pmixay/3d-project/submission/Hercules_opisanie_proekta.docx

Отраслевой молодёжный чемпионат по аддитивным технологиям «3D Профи»

IMPRINTA HERCULES: НОВЫЙ ПРИНТЕР НА СТАРОЙ РАМЕ

пересборка серийного 3D-принтера 2016 года: от оригинала остались только рама и механика осей

Направление: оборудование для 3D-печати. Команда: [Название команды]. Капитан: [Фамилия Имя], [учебное заведение], [e-mail / телефон].

1. Аннотация

Команда пересобрала серийный 3D-принтер Imprinta Hercules 2016 года. От оригинала осталась только механика: стальная рама 2 мм, линейные рельсы X и Y, ось Z, стол со стеклом, моторы осей NEMA17, ремни и дисплей. Всё остальное — электроника, печатная голова, хотенд, экструдер, драйверы, блок питания, проводка, обдув, калибровка, прошивка и программное обеспечение — новое. Принтер переведён на Klipper с 32-битной платой BigTreeTech SKR 3 EZ и платой EBB42 GEN2 на печатной голове, соединённых одним 4-жильным кабелем CAN. Печатная голова Hefest разработана командой с нуля. Автокалибровка стола контактным датчиком, компенсация резонансов, автоматическая чистка сопла и ИИ-контроль печати дают функции современных принтеров уровня Bambu Lab. Результат оценивается относительно исходного серийного Hercules (раздел 3).

2. Актуальность и необходимость

Устаревший парк оборудования. В 2015–2020 годах школы, детские технопарки «Кванториум», центры «Точка роста» и «IT-куб», ЦМИТ и вузы массово получили 3D-принтеры. Сегодня это первое поколение: 8-битная электроника, ручная калибровка, низкая скорость, отсутствие защиты и контроля печати. Такие принтеры простаивают или используются как демонстрационные, хотя их рама и механика исправны.

Высокая стоимость замены. Новый быстрый закрытый принтер класса Bambu Lab P1S стоит от 70 000 ₽ в российской рознице — для школы или кружка это бюджет на оснащение целого кабинета. При замене исправная механика старого принтера уходит в утиль.

Зависимость от закрытых экосистем. Современные быстрые принтеры опираются на фирменные запчасти, проприетарную прошивку и облачные сервисы производителя. Открытая прошивка Klipper, серийные компоненты и открытая документация дают ремонтопригодность на месте и независимость от одного поставщика.

Подготовка кадров для аддитивной отрасли. Пересборка принтера — готовый междисциплинарный учебный проект: электроника, САПР, прошивка, калибровка, метрология. Участники разбираются в устройстве оборудования, а не только пользуются им, — именно такие специалисты нужны отрасли.

Ресурсосбережение. Повторное использование рамы и механики продлевает срок службы оборудования и сокращает электронные и металлические отходы.

3. Исходный принтер и сравнение

Imprinta Hercules — принтер красноярской компании Imprinta, выпущенный в июне 2016 года: стальной каркас 2 мм, габариты 365×355×430 мм, масса около 15 кг, прямой экструдер с хотендом UniHOT, сопло 0,5 мм, ручная калибровка стола по трём точкам, заявленная скорость печати до 150 мм/с (по обзору 3Dtool на Хабре). Это типичный представитель первого поколения. Сравнение с исходным принтером:

Параметр | Серийный Hercules 2016 | Наш Hercules
Электроника | 8-битная плата, ~99 000 шагов/с | 32-битная SKR 3 EZ, более 1 800 000 шагов/с
Прошивка и управление | штатная прошивка, печать с SD-карты | Klipper, веб-интерфейс, хост на ноутбуке
Хотенд | UniHOT, до 260 °C | TriangleLab CHC Pro 115 Вт, до 300 °C
Сопло | латунное 0,5 мм | биметаллическое Volcano NCB, для композитов
Скорость печати | заявлено до 150 мм/с | цель — до 300 мм/с
Калибровка стола | ручная, по трём точкам | автоматическая, датчик 0,002 мм + адаптивная карта
Вибрации | не компенсируются | Input Shaper по встроенному акселерометру
Проводка к голове | многожильный жгут | один кабель CAN, 4 провода
Обслуживание | вручную | автоочистка сопла, ИИ-контроль печати

4. Цель и задачи

Цель — превратить устаревший серийный принтер в современный быстрый и автоматизированный принтер, сохранив только его прочную механику. Задачи:

- перевести принтер на Klipper с 32-битной платой и шиной CAN к печатной голове;
- спроектировать и напечатать собственную печатную голову Hefest под новую электронику;
- внедрить автокалибровку стола, автоматическую чистку сопла и компенсацию резонансов (Input Shaper);
- оформить решение как воспроизводимый комплект: список закупок, конфигурации, печатные детали, инструкции.

5. Техническое решение

5.1. Электроника. Плата BigTreeTech SKR 3 EZ (STM32H7, 480–550 МГц) обеспечивает более 1 800 000 шагов/с — в 18 раз больше, чем у 8-битной платы. Драйверы EZ2209 вставляются в закрытые слоты и управляются по UART, что позволяет применить klipper_tmc_autotune. Встроенный CAN-трансивер подключает плату печатной головы без отдельного адаптера. Питание — новый блок MeanWell LRS-350-24 (24 В, 350 Вт). Хостом Klipper служит ноутбук, подключённый по USB.

5.2. Плата на печатной голове. BIGTREETECH EBB42 GEN2 (40×45 мм) заменяет сразу шесть элементов: переходную плату с проводами на термоклее, внешний акселерометр с USB-кабелем, отдельный драйвер экструдера, 12-проводный жгут, длинные провода датчика и вентиляторов, генерацию шагов экструдера на основной плате. К голове идёт один кабель: 24 В, GND, CAN_H, CAN_L. Разъём XT30 рассчитан на 15 А при рабочем токе 2,94 А (пиковый при холодном старте керамического нагревателя — 5,44 А) — запас более чем в 5 раз. Выходы защищены от короткого замыкания и перегрузки, температура платы контролируется в Klipper.

5.3. Печатная голова Hefest (собственная разработка). Голова спроектирована командой в КОМПАС-3D под каретку MGN12H. Состав: силовая рама с вертикальной плитой экструдера и зажимом ремня, крышка ремня, треугольная ферма под рельсом X, две полуобоймы хотенда TriangleLab CHC Pro (передняя несёт вентилятор 3010), воздуховод обдува детали от вентилятора 5015 с выходами по обе стороны сопла. На голове размещаются экструдер K3D Minifeeder с мотором NEMA14 (редуктор 5:1), плата EBB42 GEN2 и датчик MicroProbe. Для проверки зазоров между деталями головы и ремнями написан собственный скрипт, проецирующий STL-модели вдоль рельса.

5.4. Автокалибровка стола. Стол накрыт стеклом 4 мм на зажимах: оно держит плоскость лучше тонкой алюминиевой плиты, которая коробится при нагреве до 80–110 °C. Индуктивные и вихретоковые датчики сквозь 4 мм стекла не работают, поэтому выбран контактный BIQU MicroProbe V2 (6 г, повторяемость 0,002 мм), который касается поверхности стекла металлическим штоком.

5.5. Программное обеспечение. Klipper + Klippain Shake&Tune (натяжение ремней по резонансным пикам, подбор фильтров Input Shaper по встроенному акселерометру), klipper_tmc_autotune, адаптивная карта стола KAMP, Adaptive Pressure Advance в OrcaSlicer, камера с ИИ-контролем Crowsnest + Obico (пауза при отрыве детали или «спагетти»). Макрос START_PRINT: нагрев сопла до 150 °C → чистка о силиконовую щётку → точное измерение Z-offset → карта высот только в области будущей детали → печать.

6. Бюджет

Позиция | Стоимость, ₽
Этап 1: хотенд CHC Pro, экструдер K3D Minifeeder + NEMA14, драйверы TMC, блок питания, вентиляторы | [сумма]
Плата BTT SKR 3 EZ с драйверами EZ2209 | 6 129
Плата печатной головы BTT EBB42 GEN2 V1.0 | 2 728
Датчик автокалибровки BIQU MicroProbe V2 | 1 669
Сопло TriangleLab Volcano NCB + щётки для чистки сопла | 959
Подающая шестерня RIDGA V2 для экструдера | 650
Вентилятор GDSTime 3010 + карбоновая балка X и PETG-CF | 3 180
Итого этап 2 (электроника и автоматизация) | 15 315
Полная стоимость пересборки | [итого]

Лимит этапа 2 — 20 000 ₽, запас — 4 685 ₽. Для сравнения: новый закрытый CoreXY-принтер класса Bambu Lab P1S Combo в российской рознице стоит около 70 000 ₽ и выше.

7. Техническая реализуемость

Все компоненты — серийные и доступные в России. Архитектура «плата на голове + один кабель» — отраслевой стандарт (Bambu Lab X1/P1/A1, Prusa XL, Creality K1/K2). Токи и нагрев рассчитаны заранее: рабочий ток головы 2,94 А, потери в кабеле менее 0,44 Вт, нагрев драйвера экструдера около 0,29 Вт; конструкция головы проверена на зазоры до ремней. Дальнейшая работа — доводка настроек: Input Shaper, Pressure Advance, токи драйверов и макросы.

8. Оригинальность и преимущества

- Собственная печатная голова Hefest, спроектированная под конкретную связку CHC Pro + K3D Minifeeder + EBB42 GEN2 + MicroProbe.
- Нестандартное решение для стекла: контактный датчик вместо популярных вихретоковых, которые через 4 мм стекла не работают.
- Инженерный подход: расчёт токов и тепла, собственный скрипт проверки зазоров головы — до изготовления.
- Глубокая пересборка: от серийного принтера осталась только механика; все остальные узлы подобраны и спроектированы командой как единая система.
- Функции флагманов: компенсация резонансов, автокалибровка, автоматическая чистка сопла, ИИ-контроль печати — на раме принтера 2016 года.

9. Потенциал коммерциализации

Продукт — пересборка устаревших принтеров на их собственной механике (Hercules и аналоги с прочным каркасом) вместо покупки нового принтера за 70 тыс. ₽ и выше. Целевые клиенты: школы, вузы, технопарки, ЦМИТ, кванториумы, небольшие мастерские и частные владельцы. Модели монетизации:

- готовый комплект: электроника, печатные детали головы, кабели и преднастроенная конфигурация Klipper;
- услуга пересборки «под ключ» с настройкой и обучением;
- открытая документация и файлы для самостоятельной сборки как канал привлечения клиентов.

Масштабирование — адаптация головы и конфигураций под другие популярные модели принтеров прошлого поколения.

10. Команда

Участник | Роль в проекте
[Фамилия Имя Отчество], [учебное заведение] | Капитан, архитектура и электроника
[Фамилия Имя Отчество], [учебное заведение] | Конструктор печатной головы (КОМПАС-3D)
[Фамилия Имя Отчество], [учебное заведение] | Программное обеспечение, Klipper
[Фамилия Имя Отчество], [учебное заведение] | 3D-моделирование и печать деталей
[Фамилия Имя Отчество], [учебное заведение] | Экономика, презентация, документация

11. Материалы проекта

Все материалы заявки: github.com/pmixay/3d-project/tree/main/submission

Репозиторий проекта: github.com/pmixay/3d-project

Печатная голова Hefest — описание и проверка: github.com/pmixay/3d-project/blob/main/head/README.md

Спецификация и список закупок: github.com/pmixay/3d-project/blob/main/README.md
