pmixay/3d-project/model/out/renders/front.png

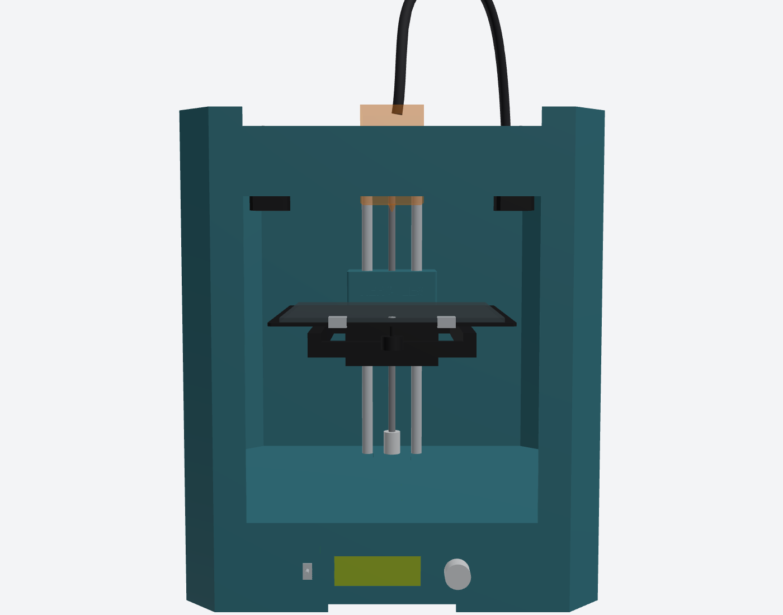
model/out/renders/front.png
