pmixay/3d-project/model/out/renders/front_iso.png

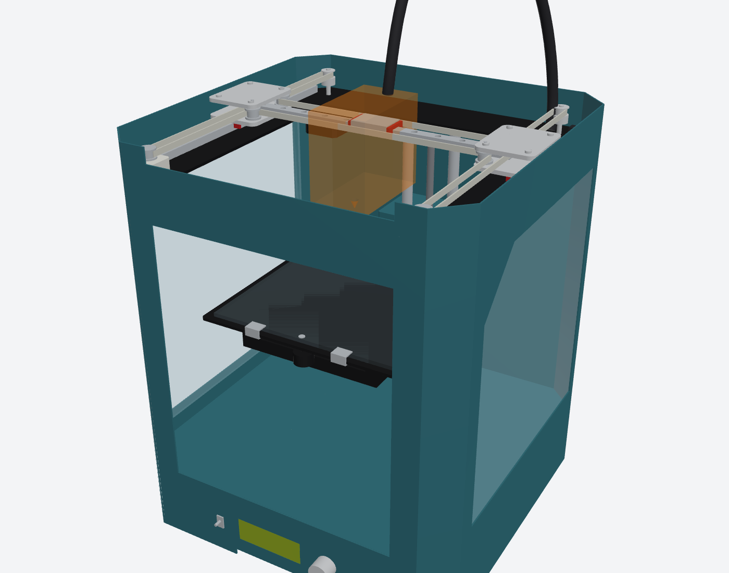
model/out/renders/front_iso.png
