pmixay/3d-project/model/out/renders/gantry_close.png

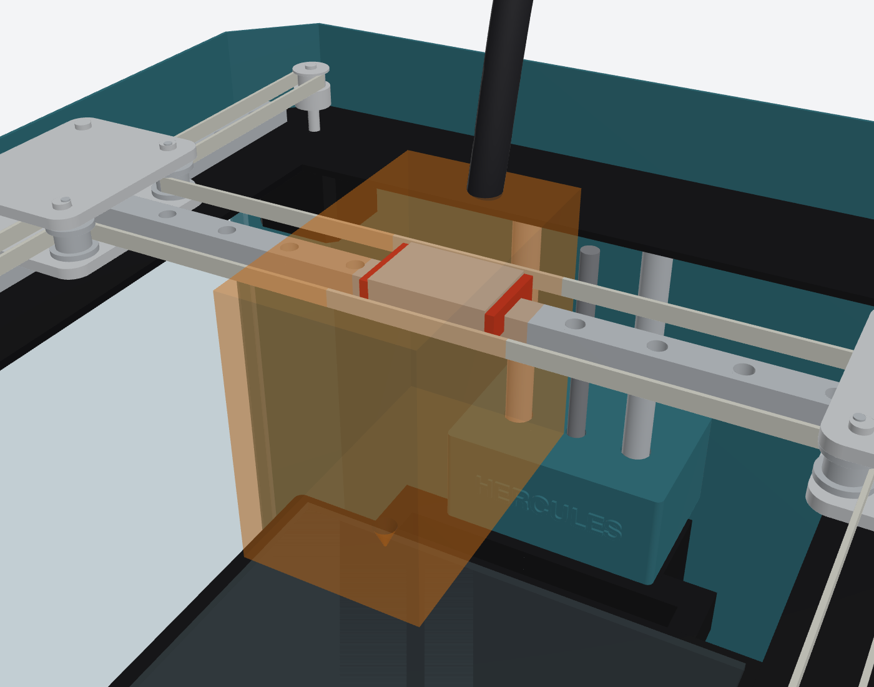
model/out/renders/gantry_close.png
