pmixay/3d-project/model/out/renders/rear_iso.png

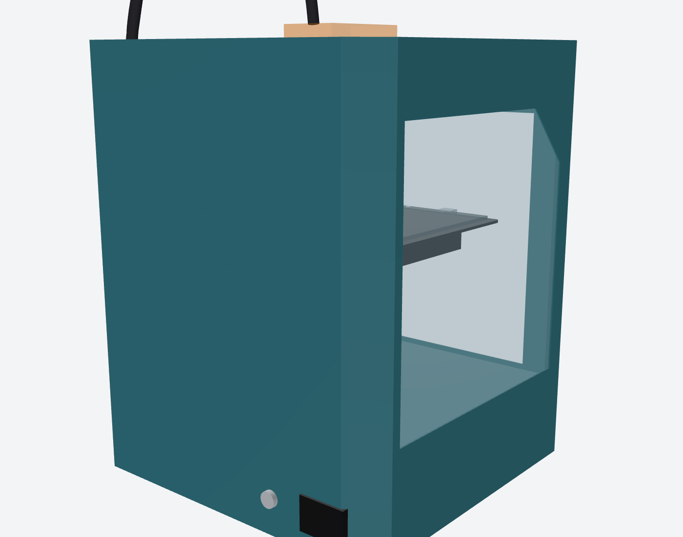
model/out/renders/rear_iso.png
