pmixay/3d-project/model/out/renders/right_iso.png

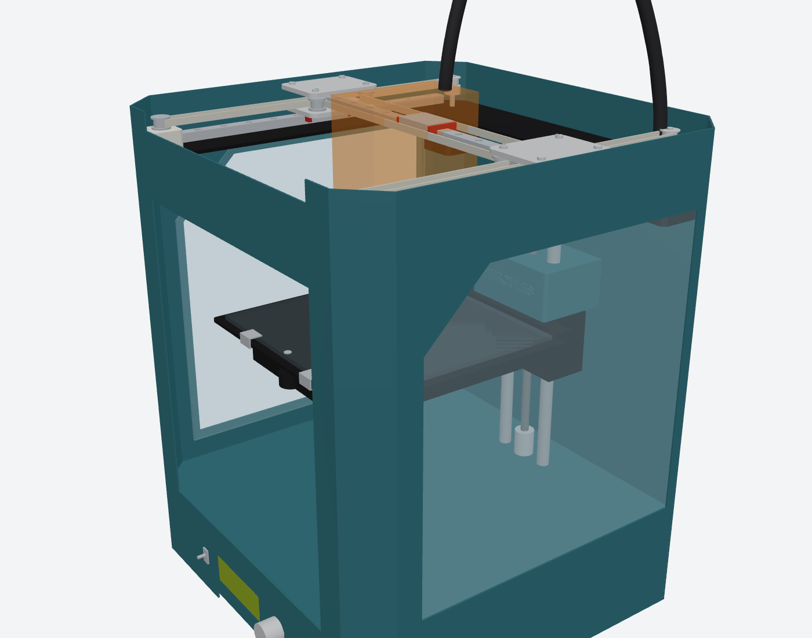
model/out/renders/right_iso.png
