pmixay/3d-project/model/out/renders/top.png

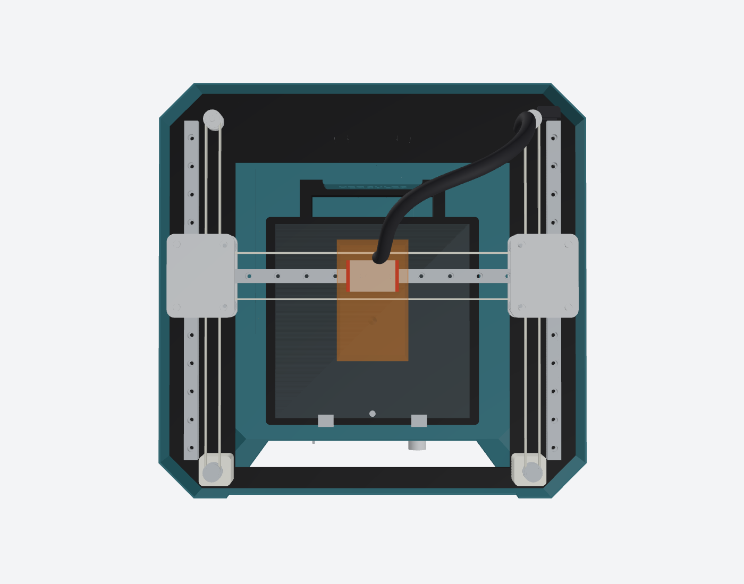
model/out/renders/top.png
