pmixay/3d-project/model/out/renders/tray_underside.png

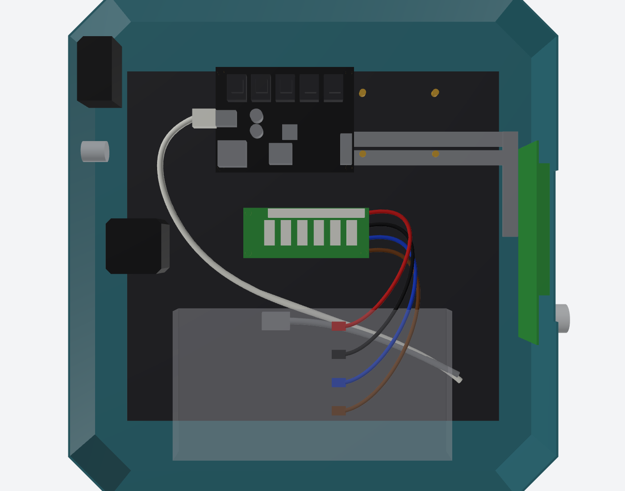
model/out/renders/tray_underside.png
