pmixay/3d-project/Components.xlsx

Component | Part name | Why it is a good choice | Price, RUB | Link | Total price:
Hotend | TriangleLab CHC Pro | Stainless-steel heater block with a copper insert, good heat transfer, optimized core geometry for improved melting; meets our volumetric flow requirement. |  | https://aliexpress.ru/item/1005003849153931.html?shpMethod=CAINIAO_FULFILLMENT_STD&sku_id=12000027332429742
Extruder stepper | NEMA14 36 mm | Compact and light, 98 g |  | https://aliexpress.ru/item/1005006423228157.html?sku_id=12000040650309424
Feed system, housing | K3D Minifeeder | Can be printed in-house, BMG-based, dual-gear feed |  | https://k3d.tech/projects/minifeeder/
Feed system, internals | BMG extruder parts | Cannot do without them |  | https://aliexpress.ru/item/1005007915797005.html?sku_id=12000047065483951
Hotend fan | 24V 3010 Fan | Compact; should be powerful enough |  | https://aliexpress.ru/item/4000144112243.html?shpMethod=CAINIAO_SUPER_ECONOMY&sku_id=12000032912110926
Part cooling fan | 24V 5015 Turbo Fan | Fits our parameters, wide airflow area, needed because of the geometry |  | https://aliexpress.ru/item/1005007569175926.html?mixer_rcmd_bucket_id=control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
Axis steppers | NEMA17 |  |  | https://aliexpress.ru/item/1005010115794476.html?sku_id=12000051196014179
Nozzles | Printfly E3D Volcano | Cheap |  | https://aliexpress.ru/item/1005005233813342.html?shpMethod=CAINIAO_STANDARD&sku_id=12000032304085730
Stepper drivers | TMC2130 | Good voltage rating and has dcStep |  | https://aliexpress.ru/item/1005008159780847.html?shpMethod=CAINIAO_STANDARD&sku_id=12000044036064878
Extruder driver | TMC 2209 | Cheap |  | https://aliexpress.ru/item/1005004862452661.html?sku_id=12000046615110841
Accelerometer | BTT ADXL345 S2DW | Middle ground of price and quality |  | https://aliexpress.ru/item/1005004243190853.html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
Power supply | LRS-350-24 | Sufficient power at a low price |  | https://www.ozon.ru/product/lrs-350-24-blok-pitaniya-korpusnoy-24v-14-6a-350vt-mw-2658922494/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
24 V LED strip | Navigator SMD 2835 NLS 6000K 24 V 9.6 W/m | Dust protection |  | https://moscow.petrovich.ru/product/1166320/
