pmixay/3d-project/3D_Printer_Upgrade_Components-v7.xlsx

Sheet: Purchase list (v7)
Purchase list for the Imprinta Hercules upgrade (v7 — BTT SKR 3 EZ + EBB42 GEN2 V1.0, actual orders as of Nov 10, 2026)
5 orders placed for 11 485 ₽ (delivery Nov 22–24). Standoffs removed (a team member already has them). Mandatory core = 12 135 ₽ (only the RIDGA V2 shaft, 650 ₽, left to buy); with reinforcement = 15 315 ₽.
No. | Budget tier | Printer unit | What to buy (item) | Notes (rationale and package contents) | Priority | Purchase status | Qty, pcs | Unit price, ₽ | Total, ₽ | Order No. / search query | Delivery by
1 | 1. Mandatory core | Mainboard + drivers | BigTreeTech SKR 3 EZ (kit with EZ2209 drivers) | SKR 3 EZ ordered for 6 129 ₽ (kit with EZ drivers). Separate drivers no longer need to be bought | Mandatory | Ordered | 1 | 6129 ₽ |  | Order No. 5552 9359 2802 4601 | Nov 24 (post office)
2 | 1. Mandatory core | Toolhead board (Toolboard Gen 2) | BIGTREETECH EBB42 GEN2 V1.0 (XT30 2+2 connector, short-circuit protection, cable) | 2nd generation (40×45 mm): XT30 (2+2) connector right on the board, temperature sensor under the driver, short-circuit protection | Mandatory | Ordered | 1 | 2728 ₽ |  | Order No. 5552 1863 3888 4601 | Nov 22
3 | 1. Mandatory core | Bed auto-leveling probe | BIQU MicroProbe V2 contact micro-probe | Probes the stock clipped-on glass directly; plugs into the 5-pin PROBE port on the EBB42 GEN2 board | Mandatory | Ordered | 1 | 1669 ₽ |  | Order No. 5552 1863 3884 4601 | Nov 23
4 | 1. Mandatory core | Hotend nozzle (high flow) | TriangleLab Volcano NCB bimetallic nozzle | Top-tier nozzle with a copper body and wear-resistant coating for the CHC Pro hotend | Mandatory | Ordered | 1 | 879 ₽ |  | Order No. 5552 9359 2800 4601 | Nov 24
5 | 1. Mandatory core | Nozzle cleaning | Silicone nozzle wiper brushes for Bambu Lab A1 (set of 3) | For automatic nozzle cleaning before Z-zero probing in the START_PRINT macro | Mandatory | Ordered | 1 | 80 ₽ |  | Order No. 5552 1863 3886 4601 | Nov 23
6 | 1. Mandatory core | Extruder internals (precision) | RIDGA V2 / IDGA integrated drive gear shaft (for BMG) | The only mandatory-core part still to be ordered: fits into the K3D Minifeeder in place of the stock gear to eliminate wall ripple | Mandatory | To buy | 1 | 650 ₽ |  | TriangleLab / FYSETC RIDGA V2 Integrated Drive Gear
7 | 2. Mechanical reinforcement & cooling | Hotend heatsink fan | High-speed GDSTime 24V 3010 Dual Ball Bearing (12000 RPM) | Dual ball bearing; guards against heat-creep clogs in the heat break better than a budget fan | Recommended | To buy | 1 | 380 ₽ |  | GDSTime 24V 3010 Dual Ball Bearing 12000RPM
8 | 2. Mechanical reinforcement & cooling | X-beam and carriage reinforcement | Carbon square tube 20x20 mm + PETG-CF / PA-CF filament (1 kg) | Removes the sag of the overhanging X rail and allows printing lightweight carriages instead of the heavy double aluminium plates | Recommended | To buy | 1 | 2800 ₽ |  | Carbon profile 20x20 mm + PETG-CF filament
9 | 3. Budget reserve (pending tests) | X and Y axis steppers | NEMA17 48 mm 2.0A low-inductance (StepperOnline 17HS19-2004S1) | Buy ONLY if the NEMA17 motors already purchased under the old list skip steps at high accelerations | Reserve | To buy | 2 | 1650 ₽ |  | StepperOnline 17HS19-2004S1 / LDO-42STH48-2004AC
 | ALREADY ORDERED AND PAID (5 orders, delivery Nov 22–24):
 | REMAINING TO BUY IN THE MANDATORY CORE (RIDGA V2 gear only):
 | TOTAL TIER 1 (Full mandatory core: ordered items + RIDGA V2):
 | TOTAL TIER 1 + 2 (With carbon X-beam reinforcement and 3010 Dual Ball fan):
 | MAXIMUM TOTAL WITH TIER 3 (Including reserve X/Y motors if needed):

Sheet: Budget control
Upgrade budget control (v7 — BTT SKR 3 EZ + EBB42 GEN2, actual orders)
Cost of the purchase tiers versus the 15 000 – 20 000 ₽ target budget, and what is already ordered.
Purchase tier | Line items | Total, ₽ | Remainder of 15 000 ₽ | Remainder of 20 000 ₽
1. Mandatory core
2. Mechanical reinforcement & cooling
3. Budget reserve (pending tests)
TOTAL (All 3 tiers)
Order status | Line items | Total, ₽
Already ordered and paid (delivery Nov 22–24)
Remaining to buy — mandatory core
Remaining to buy — tiers 1 + 2
Left of the 20 000 ₽ limit after tiers 1 + 2
