pmixay/3d-project/submission/materials/img/gantry_close.png

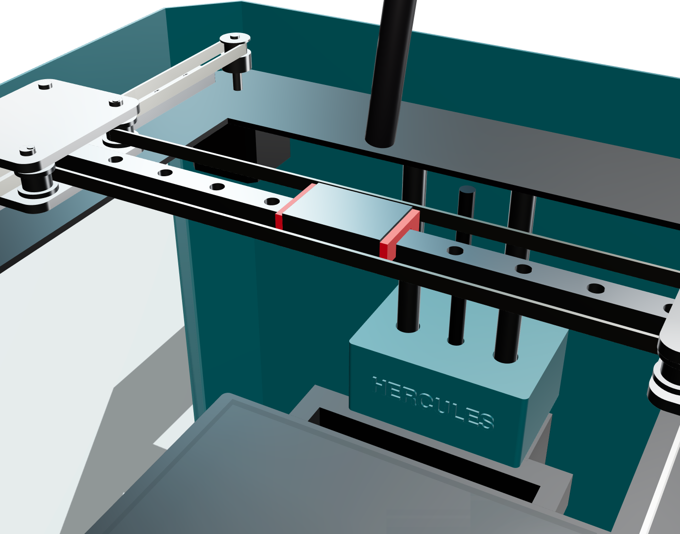
submission/materials/img/gantry_close.png
