pmixay/3d-project/submission/materials/img/hefest_parts_front.png

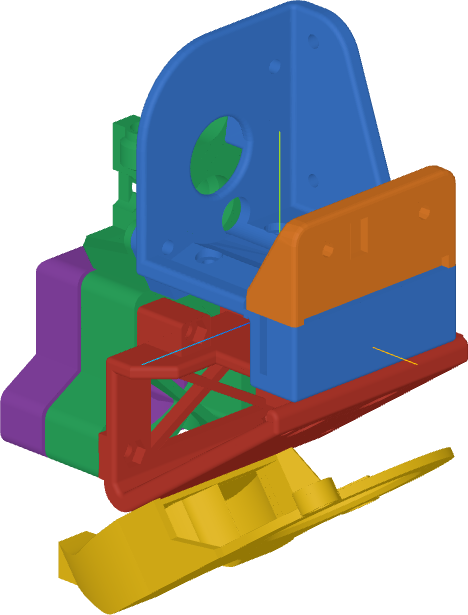
submission/materials/img/hefest_parts_front.png
