pmixay/3d-project/submission/materials/img/hefest_parts_rear.png

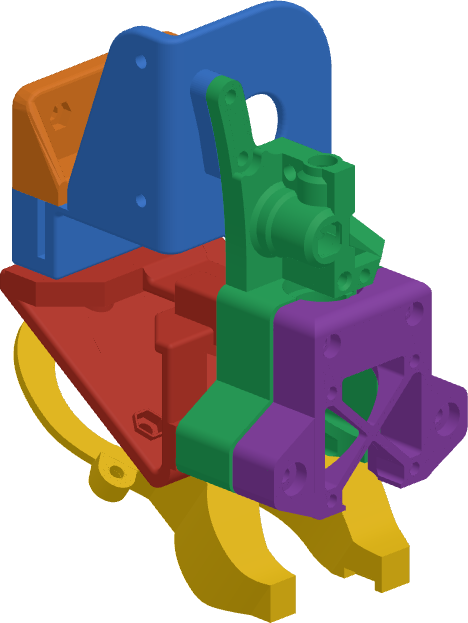
submission/materials/img/hefest_parts_rear.png
