pmixay/3d-project/submission/materials/slides/baseline.png

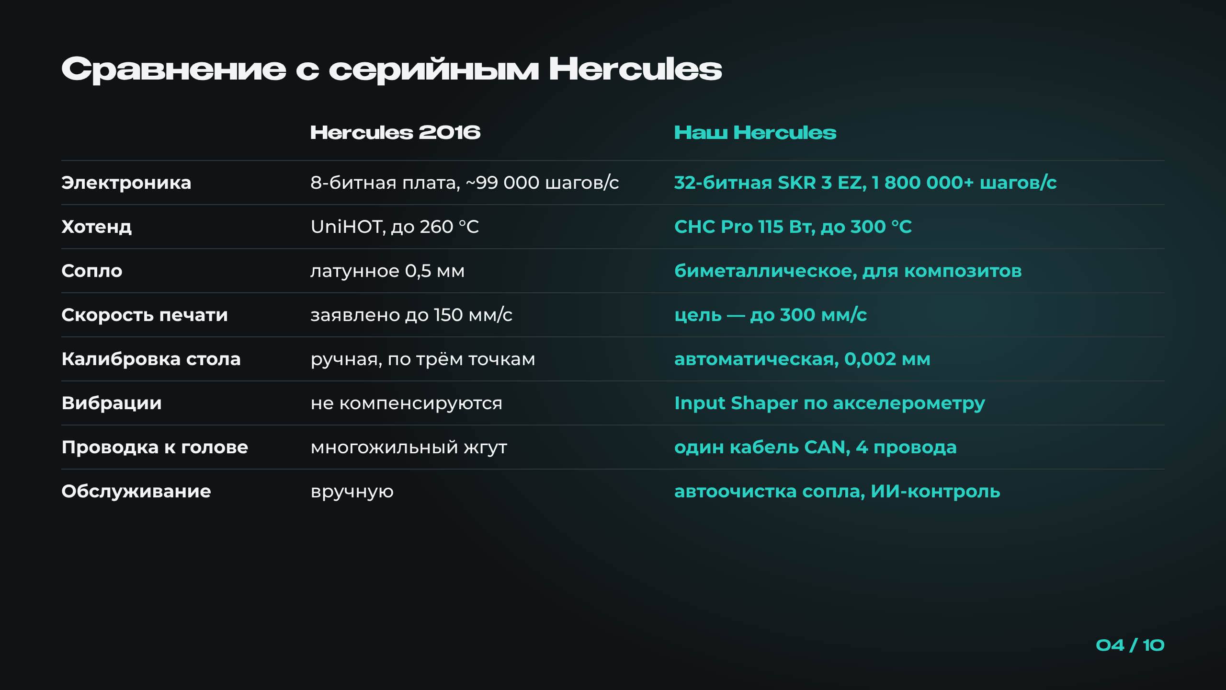
submission/materials/slides/baseline.png
