pmixay/3d-project/submission/materials/slides/budget.png

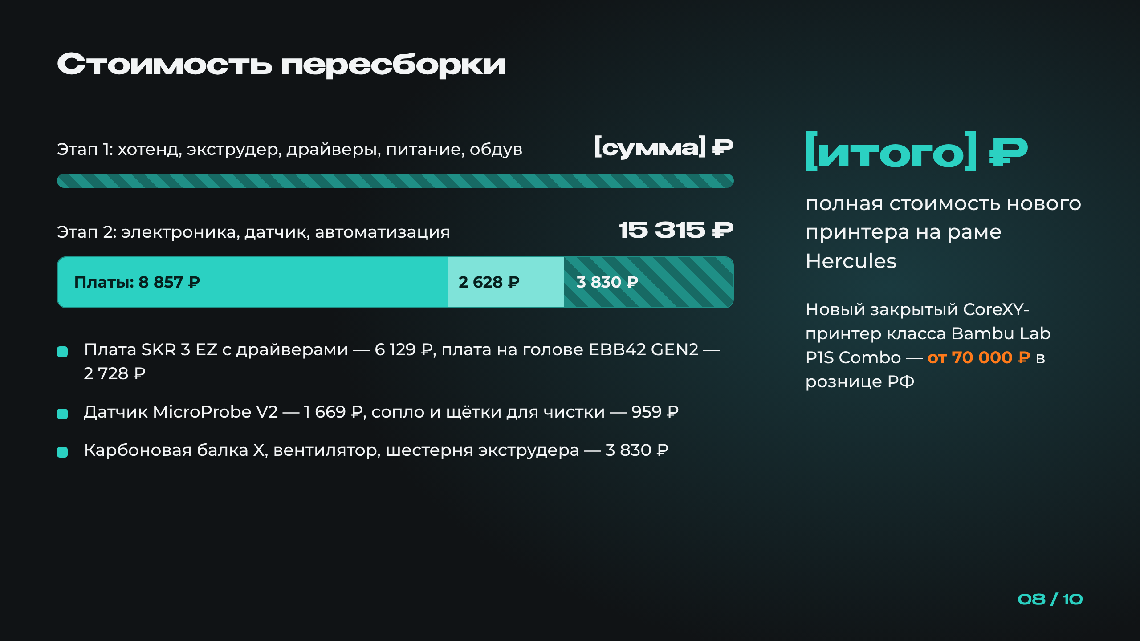
submission/materials/slides/budget.png
