pmixay/3d-project/submission/materials/slides/relevance.png

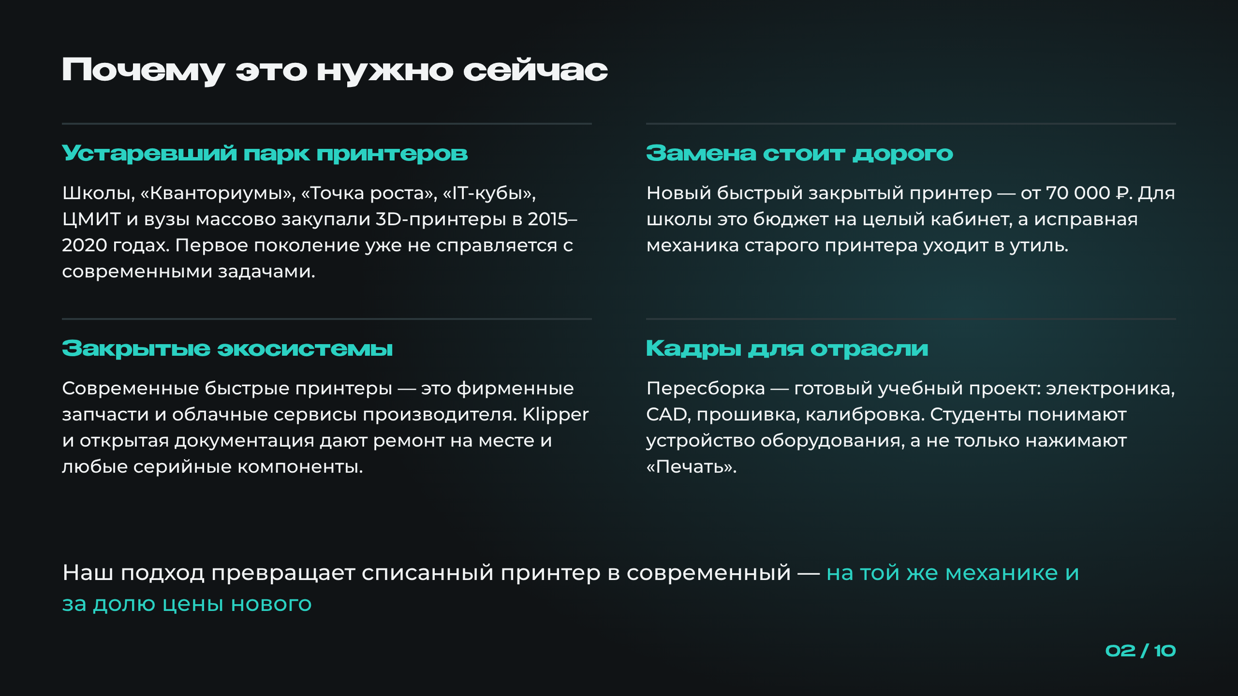
submission/materials/slides/relevance.png
