pmixay/3d-project/model/out/hercules_printer.step

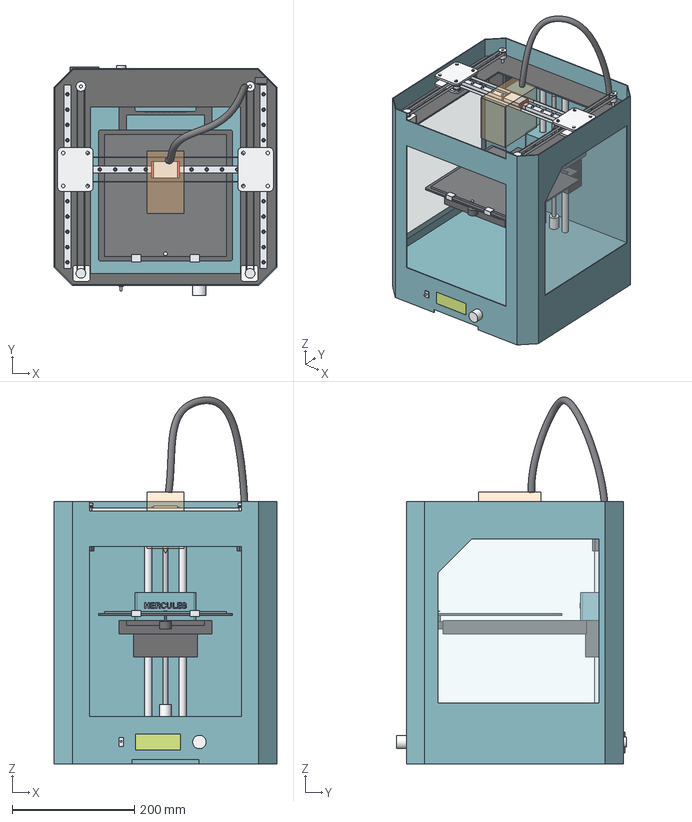
[picture p24: CAD file, 2026-11-13]
model/out/hercules_printer.step
365.0 x 376.0 x 600.7 mm
enclosure_shell
chamber_floor
side_window_left
side_window_right
lcd_screen
encoder_knob
front_toggle_switch
lcd_controller_board
top_frame_plate
y_rail_left
y_carriage_left
y_carriage_left_end_seals
x_end_plate_left_lower
x_end_plate_left_upper
x_end_idlers_left
xy_motor_left
xy_motor_pulley_left
front_idler_bracket_left
front_corner_idler_left
y_rail_right
y_carriage_right
y_carriage_right_end_seals
x_end_plate_right_lower
x_end_plate_right_upper
x_end_idlers_right
xy_motor_right
xy_motor_pulley_right
front_idler_bracket_right
front_corner_idler_right
x_rail
x_carriage
x_carriage_end_seals
belts_gt2
y_endstop_switch
toolhead_placeholder
toolhead_cable_harness
bed_heater_plate
bed_glass
bed_clips
bed_centre_screw
bed_levelling_knob
bed_support_arms
z_rods
z_lead_screw
z_carriage
z_carriage_cover_hercules
z_motor
z_coupler
tray_mounting_plate
mks_gen_v1_4_board
mks_gen_v1_4_standoffs
mks_stepper_drivers
mks_gen_v1_4_connectors
fuse_board
fuse_board_standoffs
fuse_board_fuses_and_terminals
iec_power_inlet
rear_round_connector
spare_brass_standoffs
exp_ribbon_cables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
