pmixay/3d-project/(list of files, cad)

Other CAD files:
model/out/hercules_printer.stl
