pmixay/3d-project/Hercules_3D_Printer_Upgrade_Spec_and_Plan-v3.docx

PURCHASE SPECIFICATION AND TECHNICAL UPGRADE PLAN FOR THE 3D PRINTER (v3)

Base: Imprinta Hercules | Boards: BTT SKR 3 EZ + EBB42 GEN2 V1.0 (XT30) | Reflects actual orders as of Nov 10, 2026

Already ordered (5 orders) | Remaining to buy (Mandatory core) | Tier 1 + 2 (With carbon and fan) | Remainder of the 20 000 ₽ limit
11 485 ₽ (in transit, by Nov 24) | 650 ₽ (RIDGA V2 shaft only) | 15 315 ₽ (3 830 ₽ still to spend) | +4 685 ₽ in reserve

1. Current purchase list reflecting placed orders (Revision v7)

The table contains the actual prices and order numbers of the 5 placed orders (totalling 11 485 ₽): the mainboard BTT SKR 3 EZ (6 129 ₽ kit with EZ2209 drivers), the second-generation toolhead board BIGTREETECH EBB42 GEN2 V1.0 (2 728 ₽, with XT30 2+2 connector), the BIQU MicroProbe V2 contact probe (1 669 ₽), the TriangleLab Volcano NCB nozzle (879 ₽) and a set of 3 Bambu Lab A1 wiper brushes (80 ₽). Standoffs have been removed from the list entirely (a team member already has them). The only mandatory-core item still to buy is the RIDGA V2 integrated drive gear shaft (~650 ₽).

No. | Printer unit | Part name and order number | Technical rationale and package contents | Status | Qty | Price, ₽ | Total, ₽
1 | Mainboard + drivers (1. Mandatory core) | BigTreeTech SKR 3 EZ (kit with EZ2209 drivers, order No. 5552 9359 2802 4601) Info: Order No. 5552 9359 2802 4601 (by Nov 24) | The SKR 3 EZ version was ordered for 6 129 ₽ (kit with EZ drivers, delivery by November 24). Separate drivers no longer need to be bought | Ordered (Mandatory) | 1 pc | 6 129 ₽ | 6 129 ₽
2 | Toolhead board (Toolboard Gen 2) (1. Mandatory core) | BIGTREETECH EBB42 GEN2 V1.0 (with XT30 2+2 connector, short-circuit protection and cable, order No. 5552 1863 3888 4601) Info: Order No. 5552 1863 3888 4601 (by Nov 22) | 2nd generation (40×45 mm): XT30 (2+2) connector right on the board, temperature sensor under the driver, short-circuit protection. Delivery by November 22 | Ordered (Mandatory) | 1 pc | 2 728 ₽ | 2 728 ₽
3 | Bed auto-leveling probe (1. Mandatory core) | BIQU MicroProbe V2 contact micro-probe (order No. 5552 1863 3884 4601) Info: Order No. 5552 1863 3884 4601 (by Nov 23) | Probes the stock clipped-on glass directly; plugs into the 5-pin PROBE port on the EBB42 GEN2 board. Delivery by November 23 | Ordered (Mandatory) | 1 pc | 1 669 ₽ | 1 669 ₽
4 | Hotend nozzle (high flow) (1. Mandatory core) | TriangleLab Volcano NCB bimetallic nozzle (order No. 5552 9359 2800 4601) Info: Order No. 5552 9359 2800 4601 (by Nov 24) | Top-tier nozzle with a copper body and wear-resistant coating for the CHC Pro hotend. Delivery by November 24 | Ordered (Mandatory) | 1 pc | 879 ₽ | 879 ₽
5 | Nozzle cleaning (1. Mandatory core) | Silicone nozzle wiper brushes for Bambu Lab A1 (set of 3, order No. 5552 1863 3886 4601) Info: Order No. 5552 1863 3886 4601 (by Nov 23) | For automatic nozzle cleaning before Z-zero probing in the START_PRINT macro. Delivery by November 23 | Ordered (Mandatory) | 1 pc | 80 ₽ | 80 ₽
6 | Extruder internals (precision) (1. Mandatory core) | RIDGA V2 / IDGA integrated drive gear shaft (for BMG) Info: TriangleLab / FYSETC RIDGA V2 Integrated Drive Gear | The only mandatory-core part still to be ordered: fits into the K3D Minifeeder in place of the stock gear to eliminate wall ripple | To buy (Mandatory) | 1 pc | 650 ₽ | 650 ₽
7 | Hotend heatsink fan (2. Mechanical reinforcement & cooling) | High-speed GDSTime 24V 3010 Dual Ball Bearing (12000 RPM) Info: GDSTime 24V 3010 Dual Ball Bearing 12000RPM | Dual ball bearing; guards against heat-creep clogs in the heat break better than a budget fan | To buy (Recommended) | 1 pc | 380 ₽ | 380 ₽
8 | X-beam and carriage reinforcement (2. Mechanical reinforcement & cooling) | Carbon square tube 20x20 mm + PETG-CF / PA-CF filament (1 kg) Info: Carbon profile 20x20 mm + PETG-CF filament | Removes the sag of the overhanging X rail and allows printing lightweight carriages instead of the heavy double aluminium plates | To buy (Recommended) | 1 pc | 2 800 ₽ | 2 800 ₽
9 | X and Y axis steppers (3. Budget reserve (pending tests)) | NEMA17 48 mm 2.0A low-inductance (StepperOnline 17HS19-2004S1) Info: StepperOnline 17HS19-2004S1 / LDO-42STH48-2004AC | Buy ONLY if the NEMA17 motors already purchased under the old list skip steps at high accelerations | To buy (Reserve) | 2 pcs | 1 650 ₽ | 3 300 ₽
ALREADY ORDERED AND PAID (5 orders, delivery November 22–24): | | | | | 5 pcs | | 11 485 ₽
REMAINING TO BUY IN THE MANDATORY CORE (RIDGA V2 gear only): | | | | | 1 pc | | 650 ₽
TOTAL TIER 1 (Full mandatory core: ordered items + RIDGA V2): | | | | | 6 pcs | | 12 135 ₽
TOTAL TIER 1 + 2 (With carbon X-beam reinforcement and 3010 Dual Ball fan): | | | | | 8 pcs | | 15 315 ₽
MAXIMUM TOTAL WITH TIER 3 (Including reserve X/Y motors if needed): | | | | | 10 pcs | | 18 615 ₽

2. Architecture of the ordered BTT EBB42 GEN2 V1.0 toolhead board and the BTT SKR 3 EZ board

• 1) A true XT30 (2+2) power connector right on the toolhead board (EBB42 GEN2): Unlike the first generation (which used a Molex Micro-Fit 3.0 connector), the EBB42 GEN2 V1.0 you ordered has a 15 A XT30 (2+2) power connector soldered on, and the kit includes a factory 2.2-metre shielded MX3.0-to-XT30 cable and a mating adapter board. This gives more than a 5× margin over the operating current (2.94 A) and fully replaces the old green board with hot-glued connectors and the 12-wire harness.

• 2) Built-in temperature sensor right under the extruder driver and short-circuit protection: The EBB42 GEN2 has a dedicated thermistor directly under the stepper driver IC, and the board itself is certified for operation at ambient temperatures up to 75 °C. In addition, all power outputs (the CHC Pro heater and the fans) are fitted with smart switches protected against short circuit, overload and static discharge (ESD).

• 3) Full replacement of the external accelerometer board and the separate extruder driver: The EBB42 GEN2 already carries an extruder driver and an accelerometer chip for Input Shaper (Shake&Tune), so the separate accelerometer board on the side of the K3D Minifeeder housing can be removed. The BIQU MicroProbe V2 auto-leveling probe connects with a short lead directly to the 5-pin PROBE port on the EBB42 GEN2.

• 4) A note on the ordered BTT SKR 3 EZ mainboard (6 129 ₽): The order screenshot shows the BTT SKR 3 EZ version at 6 129 ₽ — this price corresponds to the board kit with 5 genuine pinless BTT EZ2209 drivers in the box. As a result, separate axis drivers no longer need to be bought, and installation in the base tray is simpler (EZ-format drivers slide into enclosed slots like memory cards and cannot be inserted the wrong way round). If, however, the order arrives as a bare board without drivers, it will specifically need EZ2209-format drivers (or EZ-Driver Connector adapters for regular drivers).

3. What remains to be done before the orders arrive (November 22–24)

• 1) Order the RIDGA V2 drive gear shaft (~650 ₽): The only small part from the mandatory list that was missing from the order screenshot. It goes inside the assembled K3D Minifeeder extruder in place of the standard BMG gear on its shaft, to eliminate feed runout and periodic ripple on the walls.

• 2) Prepare an adapter plate for the EBB42 GEN2 (done by the team): A team member already has the standoffs, so only a flat adapter plate with a 31×31 mm mounting square (4 M3 holes) needs to be prepared before the board arrives (November 22), so the EBB42 GEN2 can be mounted horizontally in place of the old green breakout board.

• 3) Optional (within the 4 685 ₽ of budget left under the 20 000 ₽ limit): You can order the high-speed GDSTime 24V 3010 Dual Ball heatsink fan (380 ₽) and the 20×20 mm carbon tube with PETG-CF filament (2 800 ₽) to stiffen the overhanging X-axis rail and print lightweight carriages.

4. Notes from the photos of the current build (November 13, 2026)

• 1) Check the orientation of the green breakout board before making the adapter plate: In the photos the old green breakout board stands vertically at the rear of the toolhead rather than lying flat on top. Before cutting the 31×31 mm plate from item 3.2, confirm on the printer whether the EBB42 GEN2 fits horizontally in that spot or needs a vertical bracket, and that the XT30 cable has clearance from the belts.

• 2) Confirm the bed surface: The photos show a dark plate held by clips at the front edge; it cannot be told from them whether the 4 mm glass is fitted. The Z-offset and the wiper-brush position should be set for the surface actually used.

• 3) Fuse board in the base tray: Besides the MKS Gen V1.4, the base tray holds the stock green fuse board. It is kept: feed 24 V through it to the BTT SKR 3 EZ power inputs and to the XT30 toolhead cable.
