pmixay/3d-project/submission/materials/img/printer_front.png

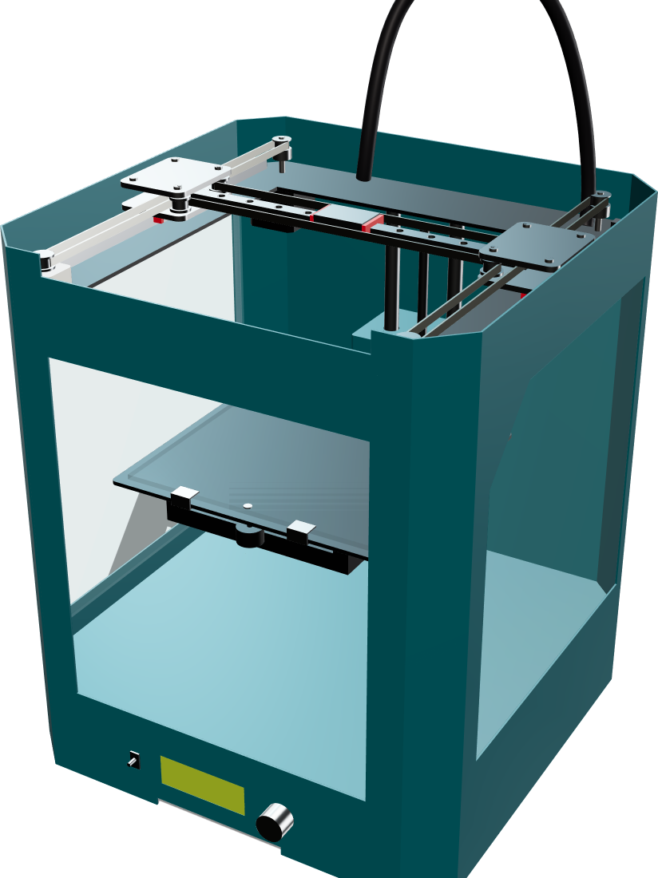
submission/materials/img/printer_front.png
