pmixay/3d-project/submission/materials/img/printer_right.png

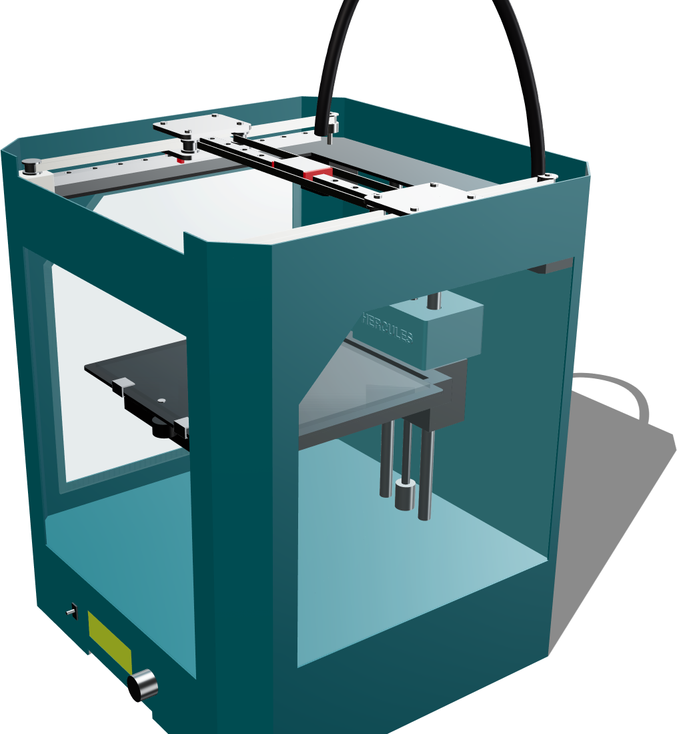
submission/materials/img/printer_right.png
