pmixay/3d-project/(commit log)

2026-11-13 Update project to spec v3 / purchase list v7 and translate to English
    - Replace the v2 spec with the v3 spec (actual orders as of Nov 10, 2026),
    translated to English, plus notes from photos of the current build
    - Replace purchase list v6 with v7: SKR 3 EZ kit, EBB42 GEN2 V1.0, actual
    prices, order numbers, delivery dates, order-status totals
    - Translate the original components list and rename all files to English
    Claude-Session: https://claude.ai/code/session_01SSoWDM7suK9sTLGVtSHTfG
    [3D_Printer_Upgrade_Components-v7.xlsx, Components.xlsx, Комплектующие.xlsx, Модернизация_3D_принтера_Комплектующие-v6.xlsx]
2026-11-13 Note that standoffs are already on hand; confirm orders against screenshot
    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
    [3D_Printer_Upgrade_Components-v7.xlsx]
2026-11-13 Add review of the Hefest print head: contents, geometry, belt corridor check
    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
2026-11-13 Add parametric printer model (work in progress snapshot)
    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
    [hercules_printer.step, hercules_printer.stl]
2026-11-13 Link the printer model and head review from the README
    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
2026-11-13 Add EBB42 GEN2 V1.0 dimensions from the official STEP model; correct board size
    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
2026-11-13 Head review: quantify the front belt gap; fix GEN2 board size in spec files
    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
    [3D_Printer_Upgrade_Components-v7.xlsx]
2026-11-13 Add 3D Profi application: presentation, project description and materials
    Claude-Session: https://claude.ai/code/session_01SSoWDNX4hJdiiz5pzQK6ei
2026-11-13 Reframe application as a rebuild from the frame up, compare against the stock Hercules, fix the QR code
    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
